kdev1966/roky-c3/boitier/apercus/arriere.png

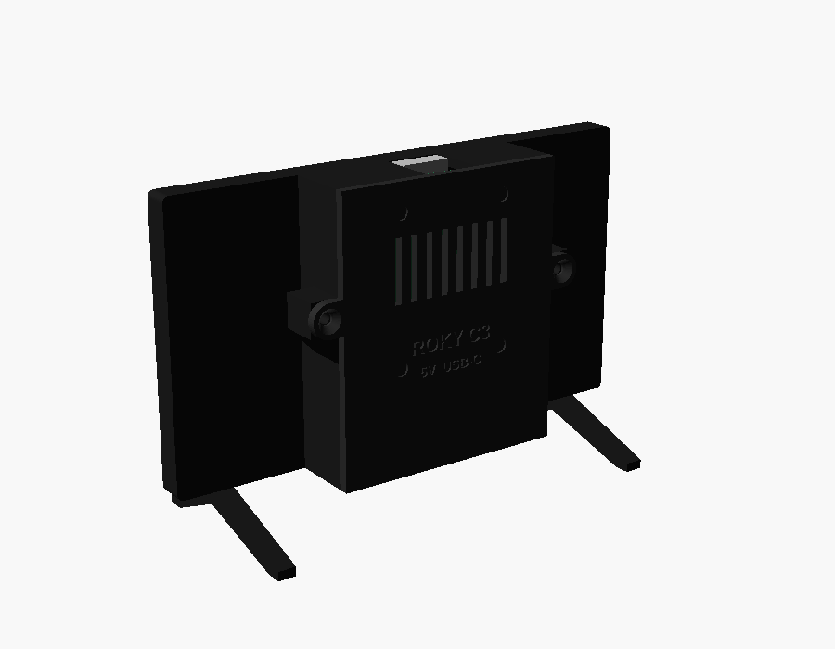
boitier/apercus/arriere.png
