kdev1966/roky-c3/boitier/apercus/cote.png

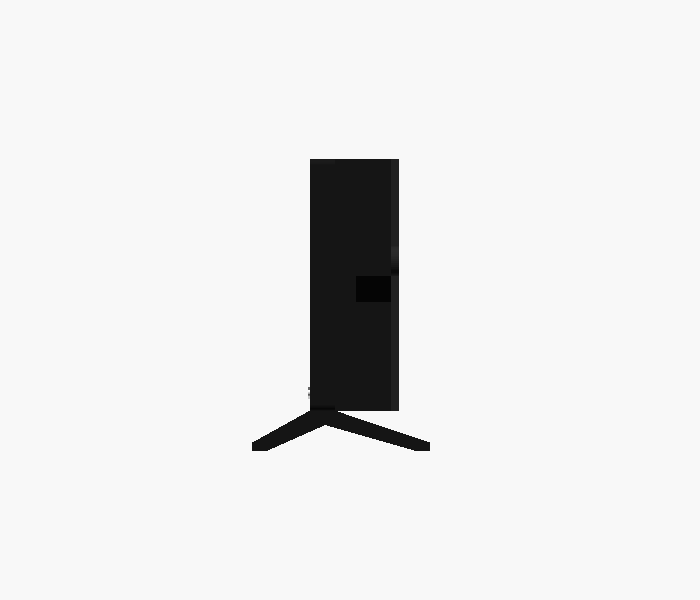
boitier/apercus/cote.png
