kdev1966/roky-c3/boitier/apercus/dalle_impression.png

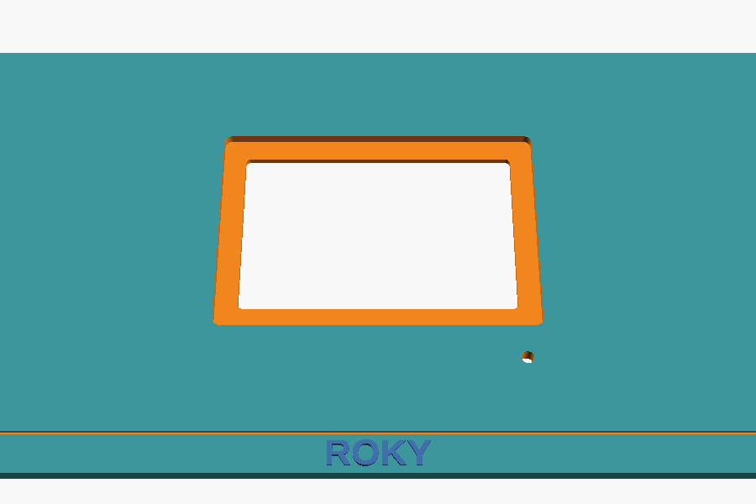
boitier/apercus/dalle_impression.png
