kdev1966/roky-c3/boitier/apercus/dessous.png

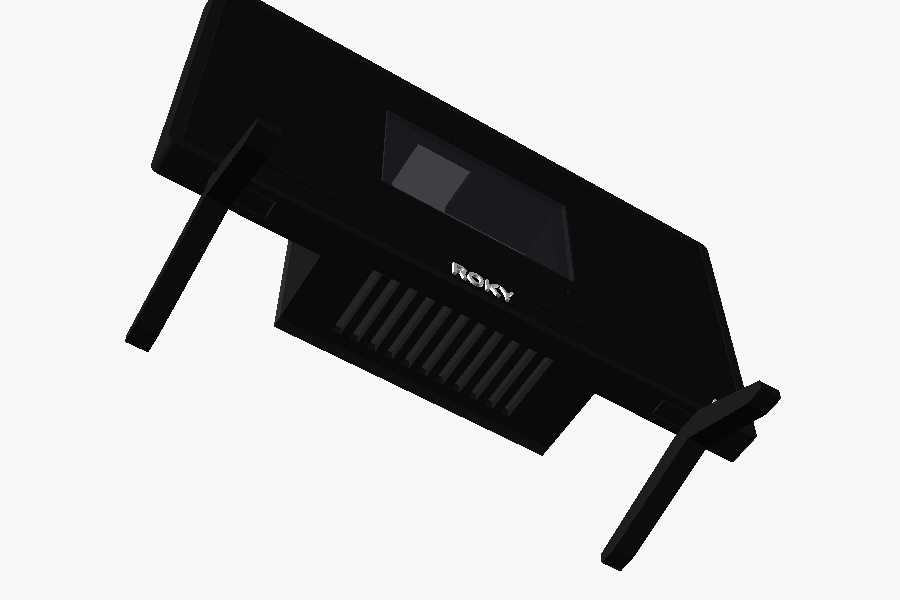
boitier/apercus/dessous.png
