kdev1966/roky-c3/boitier/apercus/eclate.png

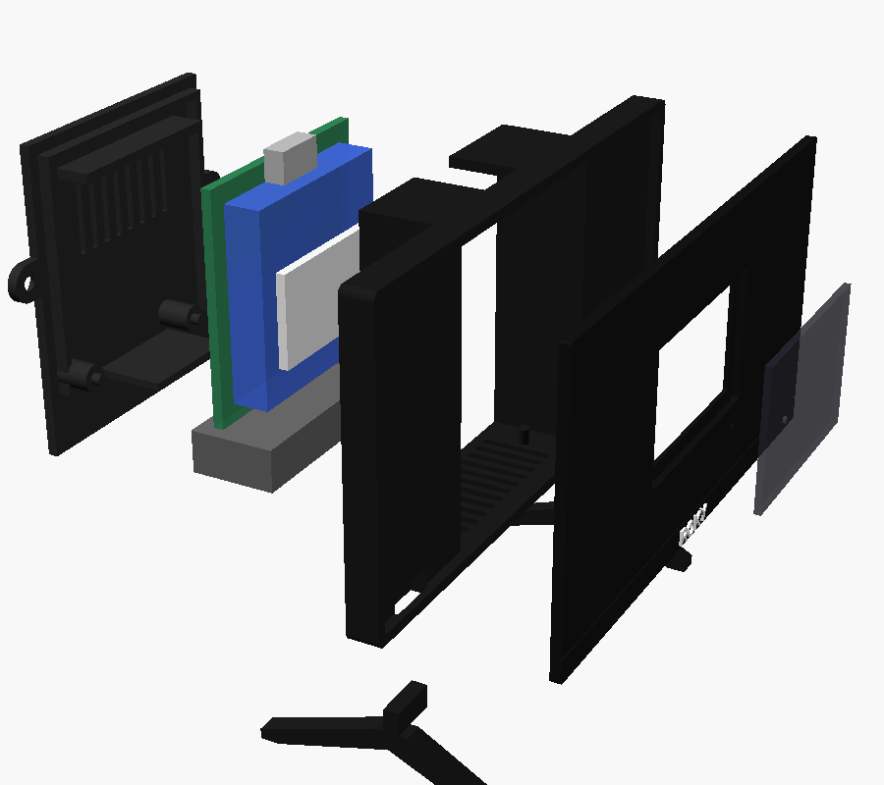
boitier/apercus/eclate.png
