kdev1966/roky-c3/boitier/apercus/face.png

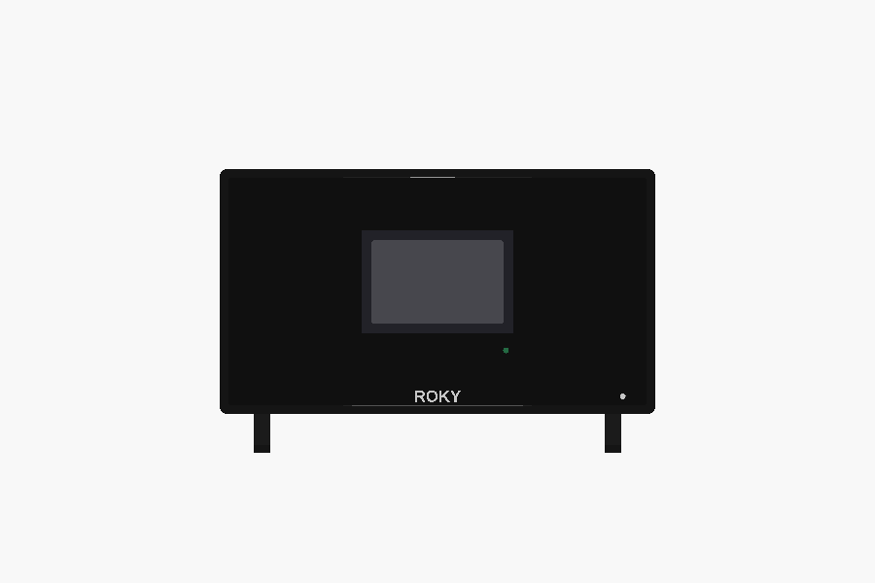
boitier/apercus/face.png
