kdev1966/roky-c3/boitier/apercus/trois_quarts.png

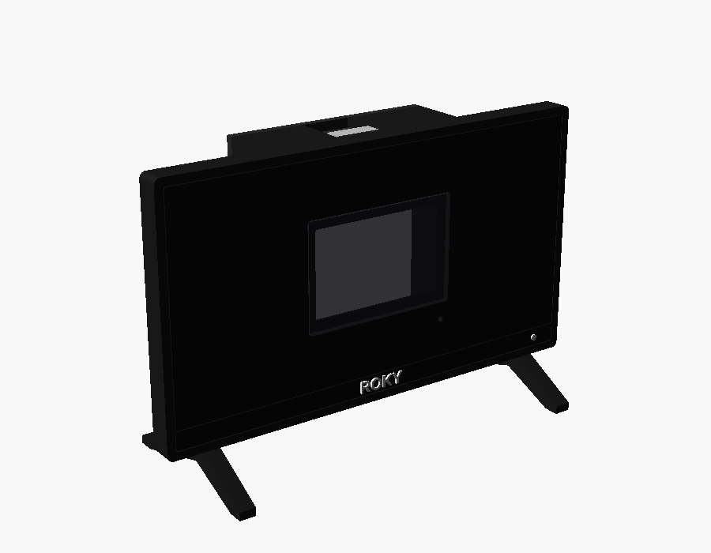
boitier/apercus/trois_quarts.png
