kdev1966/roky-c3/boitier/stl/pied_droit.stl

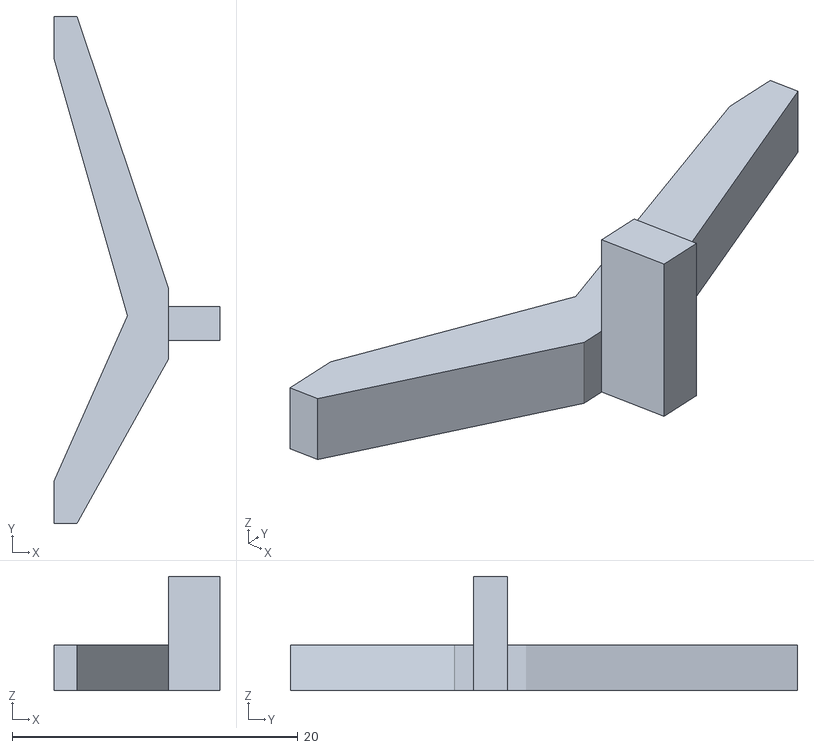
[picture p8: CAD file, 2026-10-25]
boitier/stl/pied_droit.stl
11.6 x 35.5 x 8.00
