kdev1966/roky-c3/boitier/stl/coque.stl

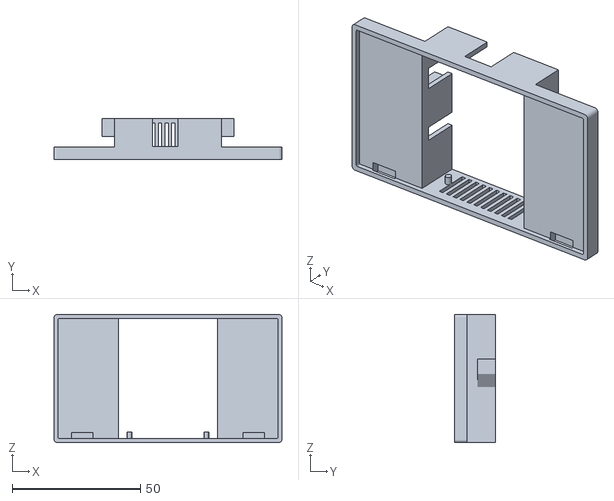
[picture p9: CAD file, 2026-10-25]
boitier/stl/coque.stl
89.0 x 16.1 x 50.0
