kdev1966/roky-c3/boitier/stl/dos.stl

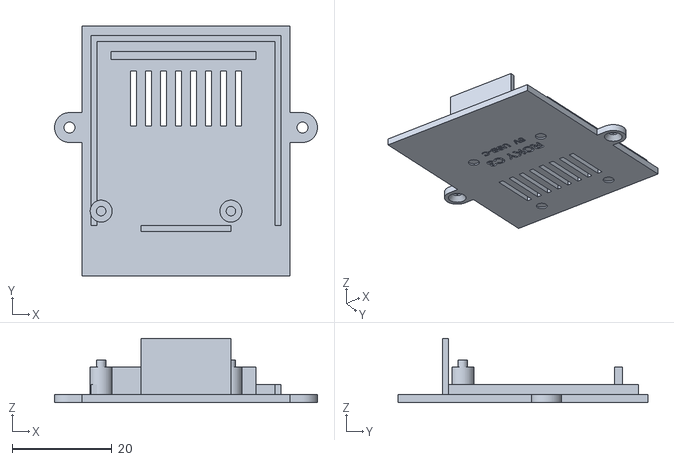
[picture p10: CAD file, 2026-10-25]
boitier/stl/dos.stl
52.7 x 50.0 x 12.9
