kdev1966/roky-c3/boitier/stl/dalle.stl

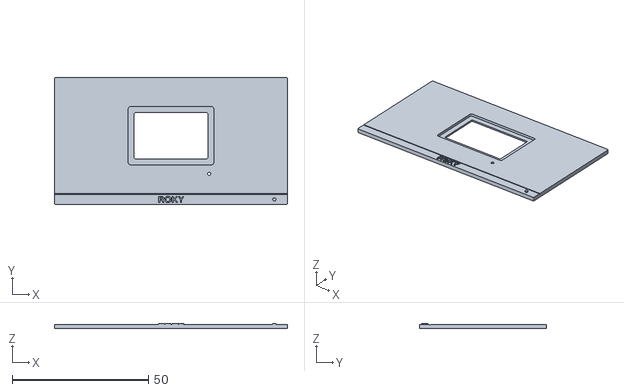
[picture p11: CAD file, 2026-10-25]
boitier/stl/dalle.stl
85.5 x 46.5 x 2.00
