kdev1966/roky-c3/(list of files, cad)

Other CAD files:
boitier/stl/pied_gauche.stl
