kdev1966/roky-c3/main/boards/roky-c3/roky_c3_board.cc

#include "wifi_board.h"
#include "codecs/es8311_audio_codec.h"
#include "face_display.h"
#include "application.h"
#include "button.h"
#include "mcp_server.h"
#include "config.h"
#include "power_manager.h"
#include "power_save_timer.h"
#include "press_to_talk_mcp_tool.h"

#include <esp_log.h>
#include <driver/i2c_master.h>
#include <esp_lcd_panel_ops.h>
#include <esp_lcd_panel_vendor.h>

#define TAG "RokyC3Board"

// Carte WHA103 (ESP32-C3, ES8311, OLED SSD1306 128x64), derivee de la Xmini-C3.
//
// Contrairement a la Xmini-C3, on ne grave PAS l'eFuse VDD_SPI_AS_GPIO : il
// l'est deja sur la WHA103 (verifie avec espefuse), et une gravure est
// irreversible. GPIO11, qui commande l'ampli, fonctionne donc deja.
class RokyC3Board : public WifiBoard {
private:
    i2c_master_bus_handle_t codec_i2c_bus_;
    esp_lcd_panel_io_handle_t panel_io_ = nullptr;
    esp_lcd_panel_handle_t panel_ = nullptr;
    Display* display_ = nullptr;
    Button boot_button_;
    PowerManager* power_manager_ = nullptr;
    PowerSaveTimer* power_save_timer_ = nullptr;
    PressToTalkMcpTool* press_to_talk_tool_ = nullptr;

    void InitializePowerManager() {
        power_manager_ = new PowerManager(BATTERY_ADC_CHANNEL);
    }

    void InitializePowerSaveTimer() {
        // -1 : la veille ne coupe ni le micro, ni le mot de reveil, ni la
        // frequence CPU. Avec 160 (valeur Xmini-C3), Roky devenait sourd a
        // « Alexa » apres 5 minutes de silence ; seul le bouton le reveillait.
        power_save_timer_ = new PowerSaveTimer(-1, 300);
        power_save_timer_->OnEnterSleepMode([this]() {
            GetDisplay()->SetPowerSaveMode(true);
        });
        power_save_timer_->OnExitSleepMode([this]() {
            GetDisplay()->SetPowerSaveMode(false);
        });
        power_save_timer_->SetEnabled(true);
    }

    void InitializeCodecI2c() {
        i2c_master_bus_config_t i2c_bus_cfg = {
            .i2c_port = I2C_NUM_0,
            .sda_io_num = AUDIO_CODEC_I2C_SDA_PIN,
            .scl_io_num = AUDIO_CODEC_I2C_SCL_PIN,
            .clk_source = I2C_CLK_SRC_DEFAULT,
            .glitch_ignore_cnt = 7,
            .intr_priority = 0,
            .trans_queue_depth = 0,
            .flags = {
                .enable_internal_pullup = 1,
            },
        };
        ESP_ERROR_CHECK(i2c_new_master_bus(&i2c_bus_cfg, &codec_i2c_bus_));

        if (!IsEs8311Present()) {
            while (true) {
                ESP_LOGE(TAG, "ES8311 not detected, please check if you have installed the correct firmware");
                vTaskDelay(1000 / portTICK_PERIOD_MS);
            }
        }
    }

    // Read the ES8311 chip ID registers (0xFD/0xFE should return 0x83/0x11).
    bool IsEs8311Present() {
        i2c_master_dev_handle_t dev = nullptr;
        i2c_device_config_t dev_cfg = {
            .dev_addr_length = I2C_ADDR_BIT_LEN_7,
            .device_address = 0x18,
            .scl_speed_hz = 100 * 1000,
        };
        if (i2c_master_bus_add_device(codec_i2c_bus_, &dev_cfg, &dev) != ESP_OK) {
            return false;
        }

        uint8_t reg = 0xFD;
        uint8_t id1 = 0, id2 = 0;
        esp_err_t err1 = i2c_master_transmit_receive(dev, &reg, 1, &id1, 1, 100);
        reg = 0xFE;
        esp_err_t err2 = i2c_master_transmit_receive(dev, &reg, 1, &id2, 1, 100);
        i2c_master_bus_rm_device(dev);

        ESP_LOGI(TAG, "ES8311 chip id: err=(%s,%s) id=0x%02X 0x%02X",
            esp_err_to_name(err1), esp_err_to_name(err2), id1, id2);
        return err1 == ESP_OK && err2 == ESP_OK && id1 == 0x83 && id2 == 0x11;
    }

    void InitializeSsd1306Display() {
        // IDF 5.5 and 6.0 declare these fields in a different order. Assign
        // them individually so C++ designated-initializer ordering is irrelevant.
        esp_lcd_panel_io_i2c_config_t io_config = {};
        io_config.dev_addr = 0x3C;
        io_config.scl_speed_hz = 400 * 1000;
        io_config.control_phase_bytes = 1;
        io_config.dc_bit_offset = 6;
        io_config.lcd_cmd_bits = 8;
        io_config.lcd_param_bits = 8;
        io_config.on_color_trans_done = nullptr;
        io_config.user_ctx = nullptr;
        io_config.flags.dc_low_on_data = 0;
        io_config.flags.disable_control_phase = 0;

        ESP_ERROR_CHECK(esp_lcd_new_panel_io_i2c(codec_i2c_bus_, &io_config, &panel_io_));

        ESP_LOGI(TAG, "Install SSD1306 driver");
        esp_lcd_panel_dev_config_t panel_config = {};
        panel_config.reset_gpio_num = GPIO_NUM_NC;
        panel_config.bits_per_pixel = 1;

        esp_lcd_panel_ssd1306_config_t ssd1306_config = {
            .height = static_cast<uint8_t>(DISPLAY_HEIGHT),
        };
        panel_config.vendor_config = &ssd1306_config;

        ESP_ERROR_CHECK(esp_lcd_new_panel_ssd1306(panel_io_, &panel_config, &panel_));
        ESP_LOGI(TAG, "SSD1306 driver installed");

        ESP_ERROR_CHECK(esp_lcd_panel_reset(panel_));
        if (esp_lcd_panel_init(panel_) != ESP_OK) {
            ESP_LOGE(TAG, "Failed to initialize display");
            display_ = new NoDisplay();
            return;
        }

        // Luminosite : le pilote ne touche ni au contraste, ni a la
        // pre-charge, ni a VCOMH, qui restent a leurs valeurs d'usine.
        const uint8_t contraste[] = {DISPLAY_CONTRAST};
        const uint8_t precharge[] = {0xF1};   // usine 0x22
        const uint8_t vcomh[]     = {0x40};   // usine 0x20
        esp_lcd_panel_io_tx_param(panel_io_, 0x81, contraste, 1);
        esp_lcd_panel_io_tx_param(panel_io_, 0xD9, precharge, 1);
        esp_lcd_panel_io_tx_param(panel_io_, 0xDB, vcomh, 1);

        ESP_LOGI(TAG, "Turning display on");
        ESP_ERROR_CHECK(esp_lcd_panel_disp_on_off(panel_, true));

        display_ = new FaceDisplay(panel_io_, panel_, DISPLAY_WIDTH, DISPLAY_HEIGHT, DISPLAY_MIRROR_X, DISPLAY_MIRROR_Y);
    }

    void InitializeButtons() {
        boot_button_.OnClick([this]() {
            auto& app = Application::GetInstance();
            if (app.GetDeviceState() == kDeviceStateStarting) {
                EnterWifiConfigMode();
                return;
            }
            if (!press_to_talk_tool_ || !press_to_talk_tool_->IsPressToTalkEnabled()) {
                app.ToggleChatState();
            }
        });
        boot_button_.OnPressDown([this]() {
            if (power_save_timer_) {
                power_save_timer_->WakeUp();
            }
            if (press_to_talk_tool_ && press_to_talk_tool_->IsPressToTalkEnabled()) {
                Application::GetInstance().StartListening();
            }
        });
        boot_button_.OnPressUp([this]() {
            if (press_to_talk_tool_ && press_to_talk_tool_->IsPressToTalkEnabled()) {
                Application::GetInstance().StopListening();
            }
        });
    }

    void InitializeTools() {
        press_to_talk_tool_ = new PressToTalkMcpTool();
        press_to_talk_tool_->Initialize();
    }

public:
    RokyC3Board() : boot_button_(BOOT_BUTTON_GPIO) {
        InitializeCodecI2c();
        InitializeSsd1306Display();
        InitializeButtons();
        InitializePowerManager();
        InitializePowerSaveTimer();
        InitializeTools();
    }

    virtual Display* GetDisplay() override {
        return display_;
    }

    virtual AudioCodec* GetAudioCodec() override {
        static Es8311AudioCodec audio_codec(codec_i2c_bus_, I2C_NUM_0, AUDIO_INPUT_SAMPLE_RATE, AUDIO_OUTPUT_SAMPLE_RATE,
            AUDIO_I2S_GPIO_MCLK, AUDIO_I2S_GPIO_BCLK, AUDIO_I2S_GPIO_WS, AUDIO_I2S_GPIO_DOUT, AUDIO_I2S_GPIO_DIN,
            AUDIO_CODEC_PA_PIN, AUDIO_CODEC_ES8311_ADDR, true, AUDIO_CODEC_PA_INVERTED);
        return &audio_codec;
    }

    virtual bool GetBatteryLevel(int& level, bool& charging, bool& discharging) override {
        if (!power_manager_ || !power_manager_->HasReading()) {
            return false;
        }
        level = power_manager_->GetBatteryLevel();
        charging = false;
        discharging = false;
        return true;
    }

    virtual void SetPowerSaveLevel(PowerSaveLevel level) override {
        if (level != PowerSaveLevel::LOW_POWER) {
            power_save_timer_->WakeUp();
        }
        WifiBoard::SetPowerSaveLevel(level);
    }
};

DECLARE_BOARD(RokyC3Board);
