kdev1966/roky-c3/(commit log)

2026-10-25 Carte roky-c3 : WHA103 (ESP32-C3, ES8311, OLED SSD1306)
    Nouvelle carte pour la WHA103, sans documentation publique : brochage
    relevé dans le firmware d'origine (xiaozhi 1.8.8). Proche de la
    Xmini-C3, mais ampli actif à l'état bas et mesure de batterie sur GPIO2.
    - visage animé et console de veille portés de Kira, sans radio ni PSRAM
    - l'eFuse VDD_SPI_AS_GPIO est déjà gravé : rien n'est gravé ici
    - la veille ne coupe plus le micro, « Alexa » reste actif
    - symbole SR_WN_WN9S_ALEXA : esp-sr fournit le modèle sans option
    - .gitignore : backup/ (la sauvegarde contient les identifiants wifi)
2026-10-25 MQTT/UDP : remettre en ordre l'audio au lieu de jeter les retardataires
    xiaozhi.me livre des paquets audio désordonnés, jusqu'à trois places de
    retard. Le contrôle de séquence les jetait, d'où des coupures audibles.
    Une fenêtre de 8 paquets ou 300 ms les remet dans l'ordre ; au-delà, le
    trou est déclaré perdu. Ce qui attend plus d'une seconde est jeté pour ne
    pas mêler deux répliques. Le transport WebSocket (TCP) n'est pas concerné.
2026-10-25 Boîtier mini TV LED pour Roky (OpenSCAD paramétrique)
    TV LED de 89 x 50 mm en PLA, clin d'œil à l'atelier de réparation TV :
    façade noire avec logo blanc (changement de filament), insert fumé devant
    l'écran, bosse arrière pour la carte, son par le dessous, pieds en V.
    Cotes dans parametres.scad, pièces et vues régénérées par construire.sh.
    [coque.stl, dalle.stl, dos.stl, parametres.scad, pied_droit.stl, pied_gauche.stl, roky_tv.scad]
2026-10-25 Écrans au thème TV : allumage, menu de service, « NO SIGNAL »
    Roky vit dans une mini TV LED chez un réparateur de TV : la console
    mainframe héritée de Kira laisse place à des écrans de son métier.
    - allumage : logo ROKY, barre de chargement, nom de l'atelier
    - au repos : SERVICE MODE (valeurs réelles) 15 s, puis « NO SIGNAL »
    qui rebondit 45 s, ce qui évite de marquer l'OLED
    - coordonnées de l'atelier dans atelier.h, ignoré par git (dépôt
    public) ; atelier.h.exemple sert de repli
2026-10-26 roky-c3 : écran OLED plus lumineux (contraste, pré-charge, VCOMH)
    Le pilote SSD1306 d'ESP-IDF ne règle pas la luminosité : l'écran restait
    à ses valeurs d'usine (contraste 127). Contraste au maximum, pré-charge
    0xF1 et VCOMH 0x40, pour compenser le film de protection posé devant
    l'écran. Valeur du contraste réglable dans config.h (DISPLAY_CONTRAST).
2026-10-26 roky-c3 : contraste de l'OLED à 207 au lieu du maximum
    Le maximum use l'OLED plus vite, et l'écran reste allumé toute la journée
    à l'atelier. 207 (0xCF) est la valeur usuelle avec la pompe de charge :
    plus lumineux que l'usine (127), sans pousser le courant des pixels.
2026-11-09 roky-c3 : mot de reveil Alexa fixe dans la configuration de la carte (plus de Ni hao Xiaozhi sans --wake-word)
2026-11-12 roky-c3 : une question par mot de reveil (retour en veille apres chaque reponse)
    Nouvelle option SINGLE_TURN_AFTER_WAKE_WORD (desactivee par defaut) :
    a la fin d'une reponse en mode arret automatique, l'appareil repasse en
    veille au lieu de reecouter, pour ne pas repondre aux conversations
    voisines. Activee pour roky-c3 seulement.
    Le mot de reveil sort de config.json (regle du depot verifiee par
    scripts/tests) : construire avec --language fr-FR --wake-word wn9s_alexa.
